MSandro93/solaranlage/Production Files/Rev_B/BOM_Solaranlage_Rev.B.xlsx

Quantity | Designator | Value | Supplier | Ordering | Description
1 | BZ1 | AL-60SP05/HT | Conrad | 541347-62 | Buzzer, polarized | o
2 | C12 C13 | 10p | Conrad | 1589402-62 | Unpolarized capacitor
7 | C1 C5 C6 C8 C9 C15 C20 | 10n | Conrad | 1235236-62 | Unpolarized capacitor | o
10 | C2 C3 C4 C10 C14 C17 C19 C21 C7 C22 | 100n | Conrad | 1235240-62 | Unpolarized capacitor | o
4 | C11 C16 C18 C23 | 10uF | Conrad | 1688108-62 | Polarized capacitor | o
5 | D8 D9 D10 D11 D14 | D_TVS | Conrad | 140810-62 | TVS diode | o
2 | D2 D3 | LED_green_5mm | Conrad | 1573746-62 | Light emitting diode | o
1 | D1 | LED_red_5mm | Conrad | 1573740-62 | Light emitting diode | o
6 | D4 D5 D6 D7 D12 D13 | LED_yellow_3mm | Conrad | 1573698-62 | Light emitting diode | o
1 | F1 | Fuse | Conrad | 1898867-62 / 1898865-62 | Fuse | o
1 | J3 | AVR-JTAG-10 | Conrad | 1088159-62 | Atmel 10-pin JTAG connector | o
3 | J1 J2 J6 | Screw_Terminal_01x02 | Digikey | A98092-ND | Screw terminal, single row, 01x02
1 | J7 | Screw_Terminal_01x03 | Digikey | A98093-ND | Screw terminal, single row, 01x03
2 | J4 J5 | USB_B | Conrad | 1883654-62 |  | o
1 | JP1 | Jumper | Conrad | 739443-62 / 734129-62 | Jumper, normally closed | o
3 | L1 L2 L3 | 10uH | Conrad | 440313-62 | Inductor symbol for simulation only | o
1 | MECH5 | Socket for ATMega32 (U7) | Reichelt | GS 40P
2 | MECH1 MECH2 | Socket for NE555 (U10) | Conrad | 189600-62 |  | o
2 | MECH3 MECH4 | Socket for buffer (U11) | Conrad | 189626-62 |  | o
2 | Q1 Q2 | 2N3904 | Reichelt | 2N 3904 | 0.2A Ic, 40V Vce, Small Signal NPN Transistor, TO-92
8 | R3 R4 R5 R6 R7 R8 R9 R10 | 220 | Reichelt | YAG FTE52-220R | Resistor
6 | R25 R26 R27 R28 R31 R32 | 330 | Reichelt | METALL 330 | Resistor
3 | R17 R18 R20 | 560 | Reichelt | YAG FTE52-560R | Resistor
8 | R1 R2 R12 R13 R19 R21 R23 R35 | 1k | Reichelt | VIS C1001FC100 | Resistor
1 | R33 | 4k7 | Reichelt | VIS C4701FC100 | Resistor
9 | R11 R14 R15 R16 R22 R24 R29 R30 R34 | 10k | Reichelt | METALL 10,0K | Resistor
2 | RV1 RV2 | R_POT_TRIM | Conrad | 447564-62 | Trim-potentiometer | o
1 | SW2 | 100SP1T1B4M2QE | Digikey | EG2355-ND | Switch, single pole double throw
1 | SW1 | Rotary_Encoder | Digikey | P12423-ND | Rotary_Encoder
1 | U12 | 74HC595 | Reichelt | 74HC 595 | 8-bit serial in/out Shift Register 3-State Outputs
1 | U11 | 74LS126 | Reichelt | LS 126 | Quad buffer 3-State outputs
1 | U7 | ATmega32-16PU | Reichelt | ATMEGA 32-16 DIP | MCU
1 | U8 | FT232RL | Reichelt | FT 232 RL | USB to Serial Interface, SSOP-28
1 | U9 | MCP6002-I/P | Conrad | 651489-62 | Dual Rail-to-rail CMOS Operational Amplifier, DIP-8/SOIC-8 | o
1 | U10 | NE555P | Reichelt | NE 555 TEX | Precision Timers, 555 compatible, PDIP-8
6 | U1 U2 U3 U4 U5 U6 | SC56-11E* | Reichelt | SC 56-11 RT | One digit 7 segment hyper red LED, common cathode
1 | Y1 | 7.3728 Mhz | Reichelt | 7,3728-HC49U-S | Two pin crystal
1 | - | Nuts M3 | Reichelt | SZK M3X6-200 | 200-pack of M3 screws for mechanical assembly
6 | - | distance bolt M3 | Reichelt | VT DA 12MM | distance bolts for mechanical assembly
1 | - | screw M3 | Reichelt | SK-E M3-100 | 100-pack of M3 nuts for mechanical assembly
