MSandro93/solaranlage/3D/fuse_asm.stp

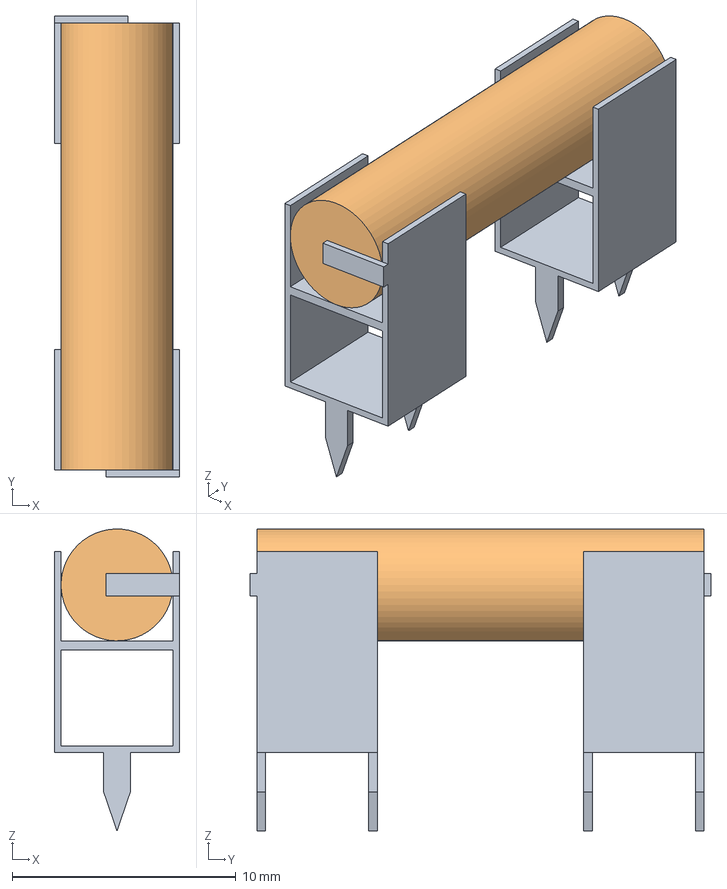
[picture p1: CAD file, 2021-03-04]
3D/fuse_asm.stp
5.60 x 20.6 x 13.5 mm
fuse_clip x 2
fuse
