MSandro93/solaranlage/3D/dispaly_cover.stp

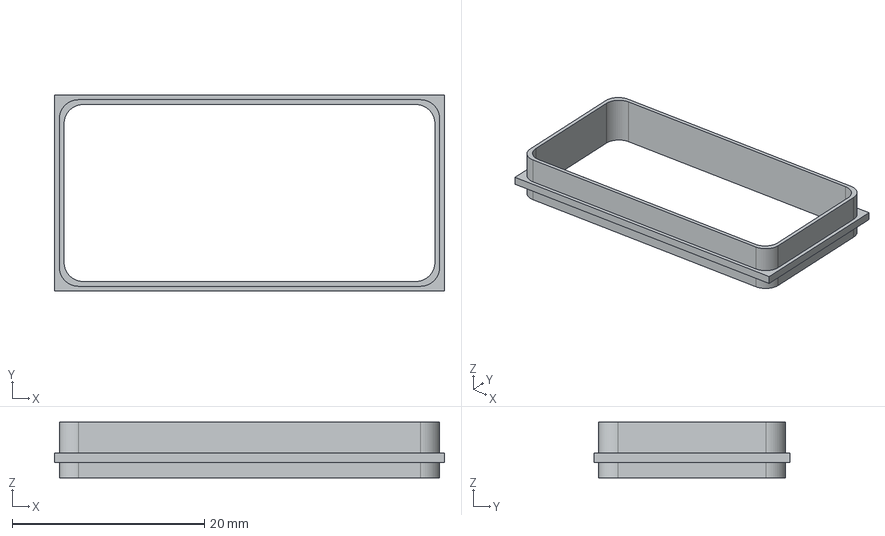
[picture p2: CAD file, 2021-03-14]
3D/dispaly_cover.stp
40.6 x 20.4 x 5.79 mm
