MSandro93/solaranlage/3D/frontplate.step

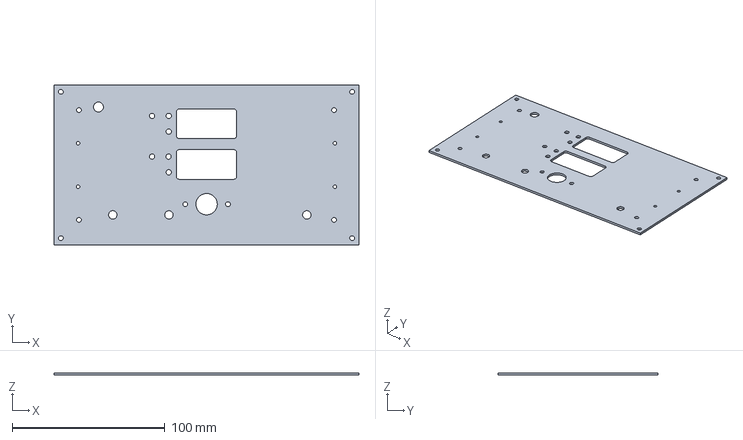
[picture p3: CAD file, 2021-03-12]
3D/frontplate.step
200.0 x 105.0 x 1.60 mm
