MSandro93/solaranlage/3D/terminal_block_x3.STEP.STEP

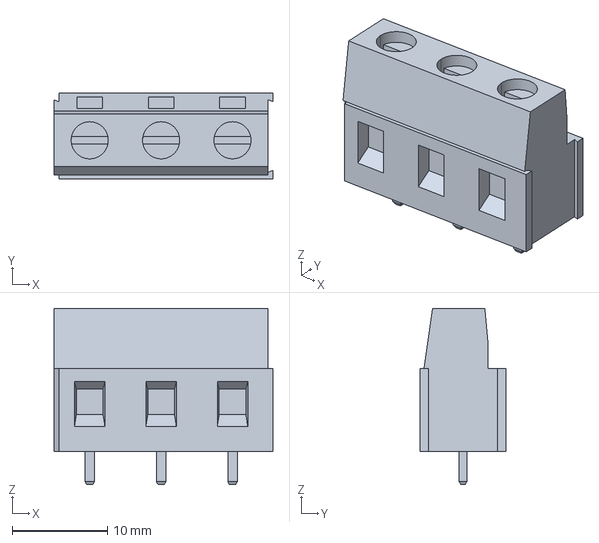
[picture p4: CAD file, 2021-03-02]
3D/terminal_block_x3.STEP.STEP
23.0 x 9.00 x 18.5 mm
