MSandro93/solaranlage/3D/terminal_block_x2.STEP

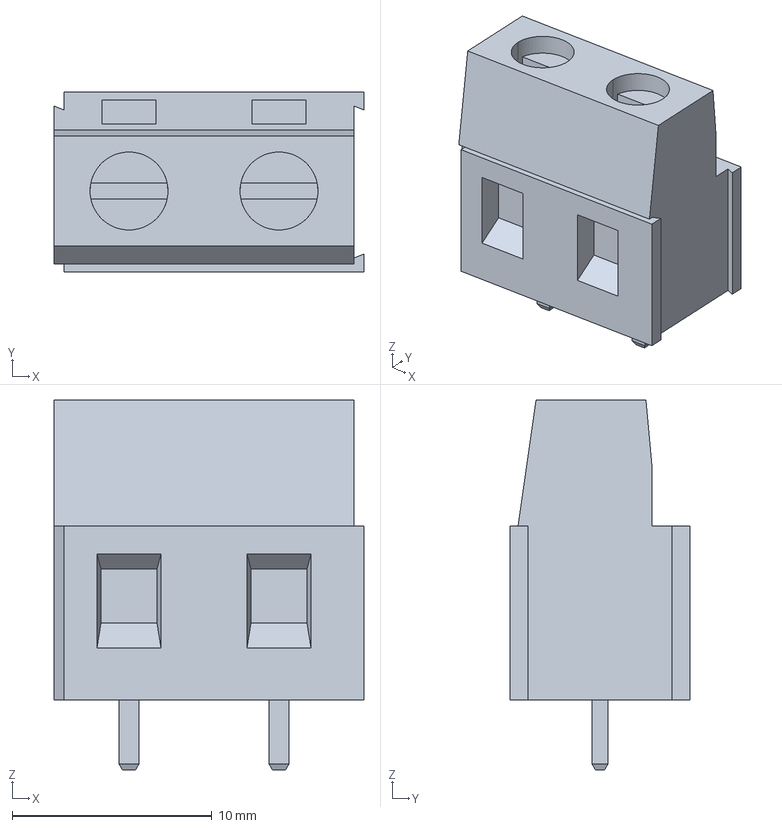
[picture p5: CAD file, 2021-03-02]
3D/terminal_block_x2.STEP
15.5 x 9.00 x 18.5 mm
