MSandro93/solaranlage/3D/encoder.stp

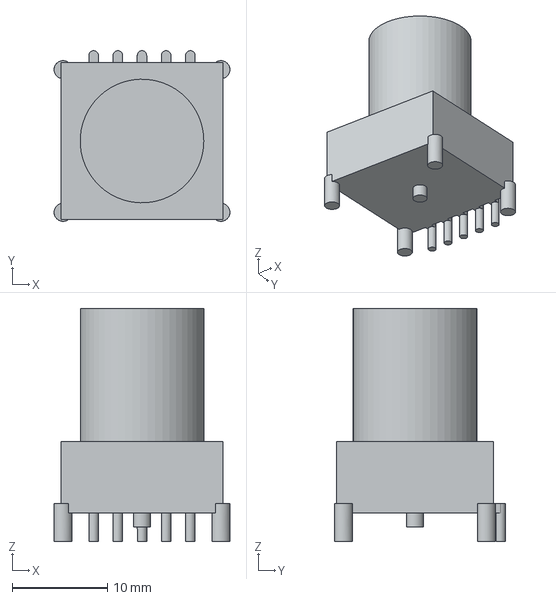
[picture p6: CAD file, 2021-02-25]
3D/encoder.stp
18.5 x 17.9 x 24.5 mm
