MSandro93/solaranlage/3D/toggle_switch.STEP

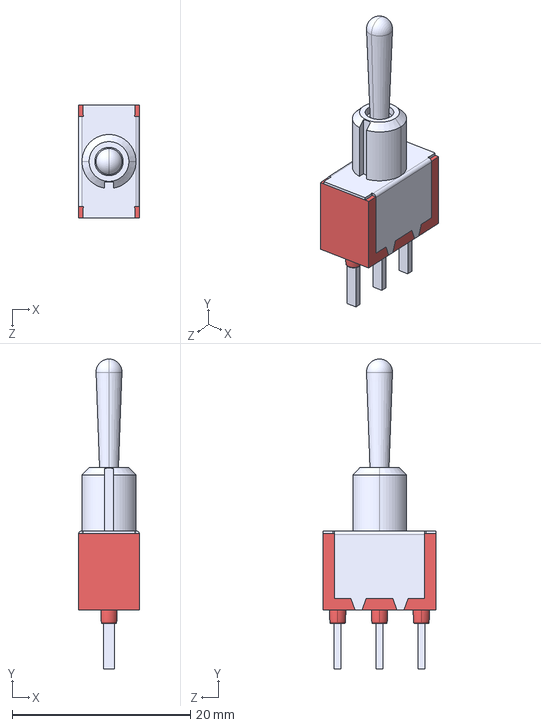
[picture p7: CAD file, 2021-02-25]
3D/toggle_switch.STEP
6.86 x 34.8 x 12.7 mm
