MSandro93/solaranlage/3D/USB_B.stp

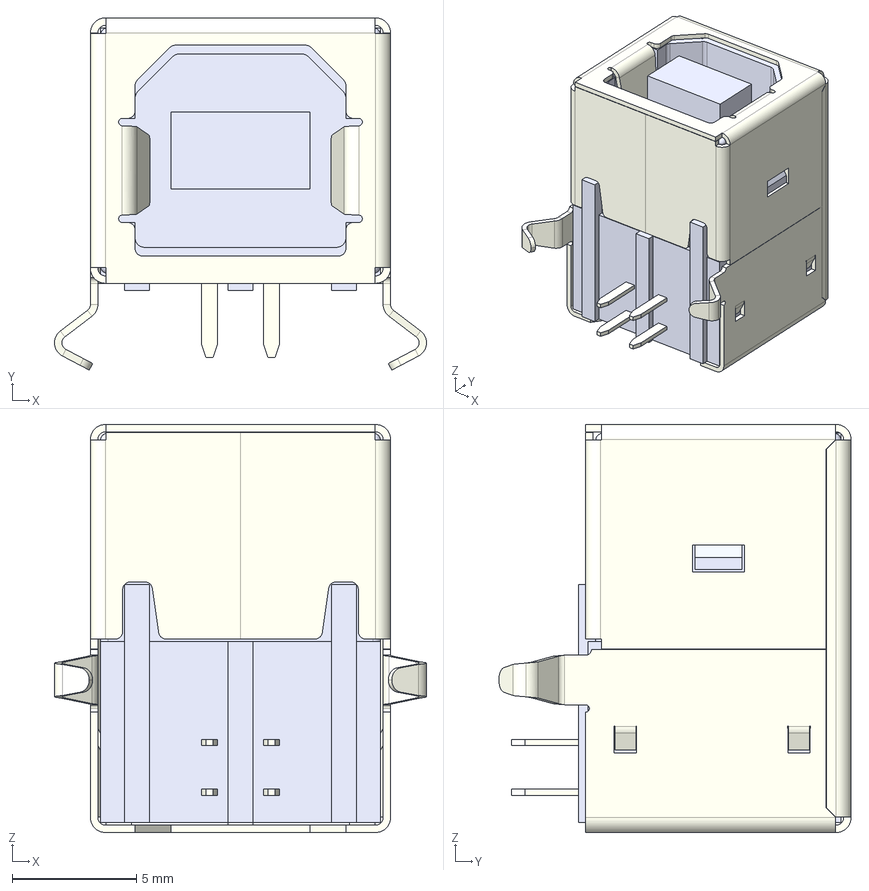
[picture p8: CAD file, 2021-02-25]
3D/USB_B.stp
15.0 x 14.2 x 16.5 mm
