MSandro93/solaranlage/3D/61201021721 (rev1).stp

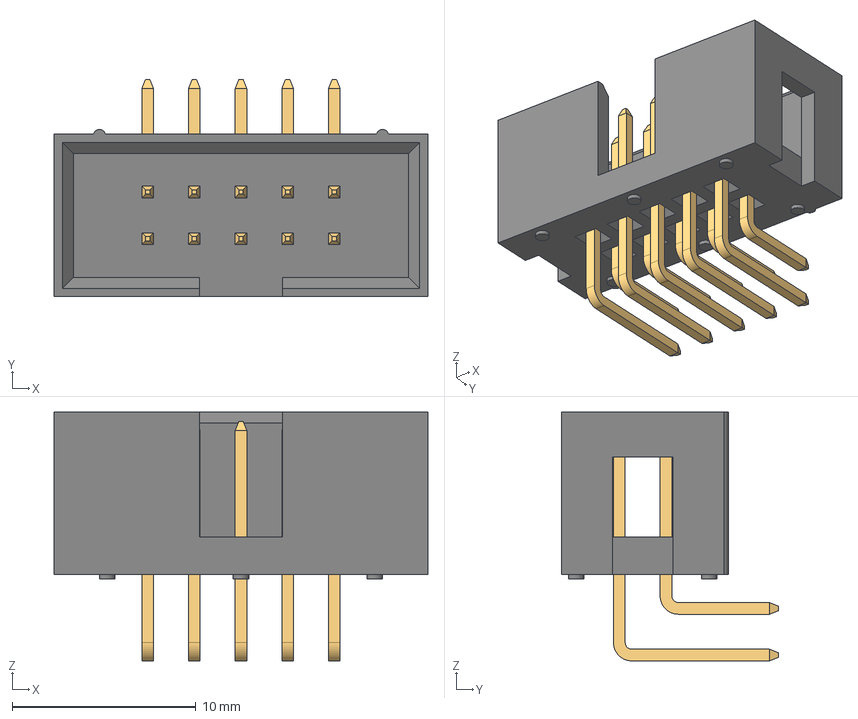
[picture p9: CAD file, 2021-03-04]
3D/61201021721 (rev1).stp
20.4 x 11.8 x 13.6 mm
6120xx21721_PIN x 5
6120xx21721_PIN_LONGUE x 5
