MSandro93/solaranlage/3D/696101000002 (rev1).stp

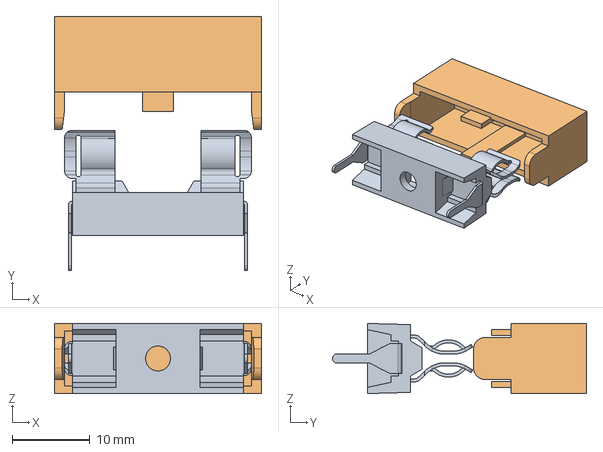
[picture p10: CAD file, 2021-03-04]
3D/696101000002 (rev1).stp
26.6 x 32.6 x 9.00 mm
