MSandro93/solaranlage/Production Files/Rev_B/SCH_Solaranlage_Rev.B.pdf

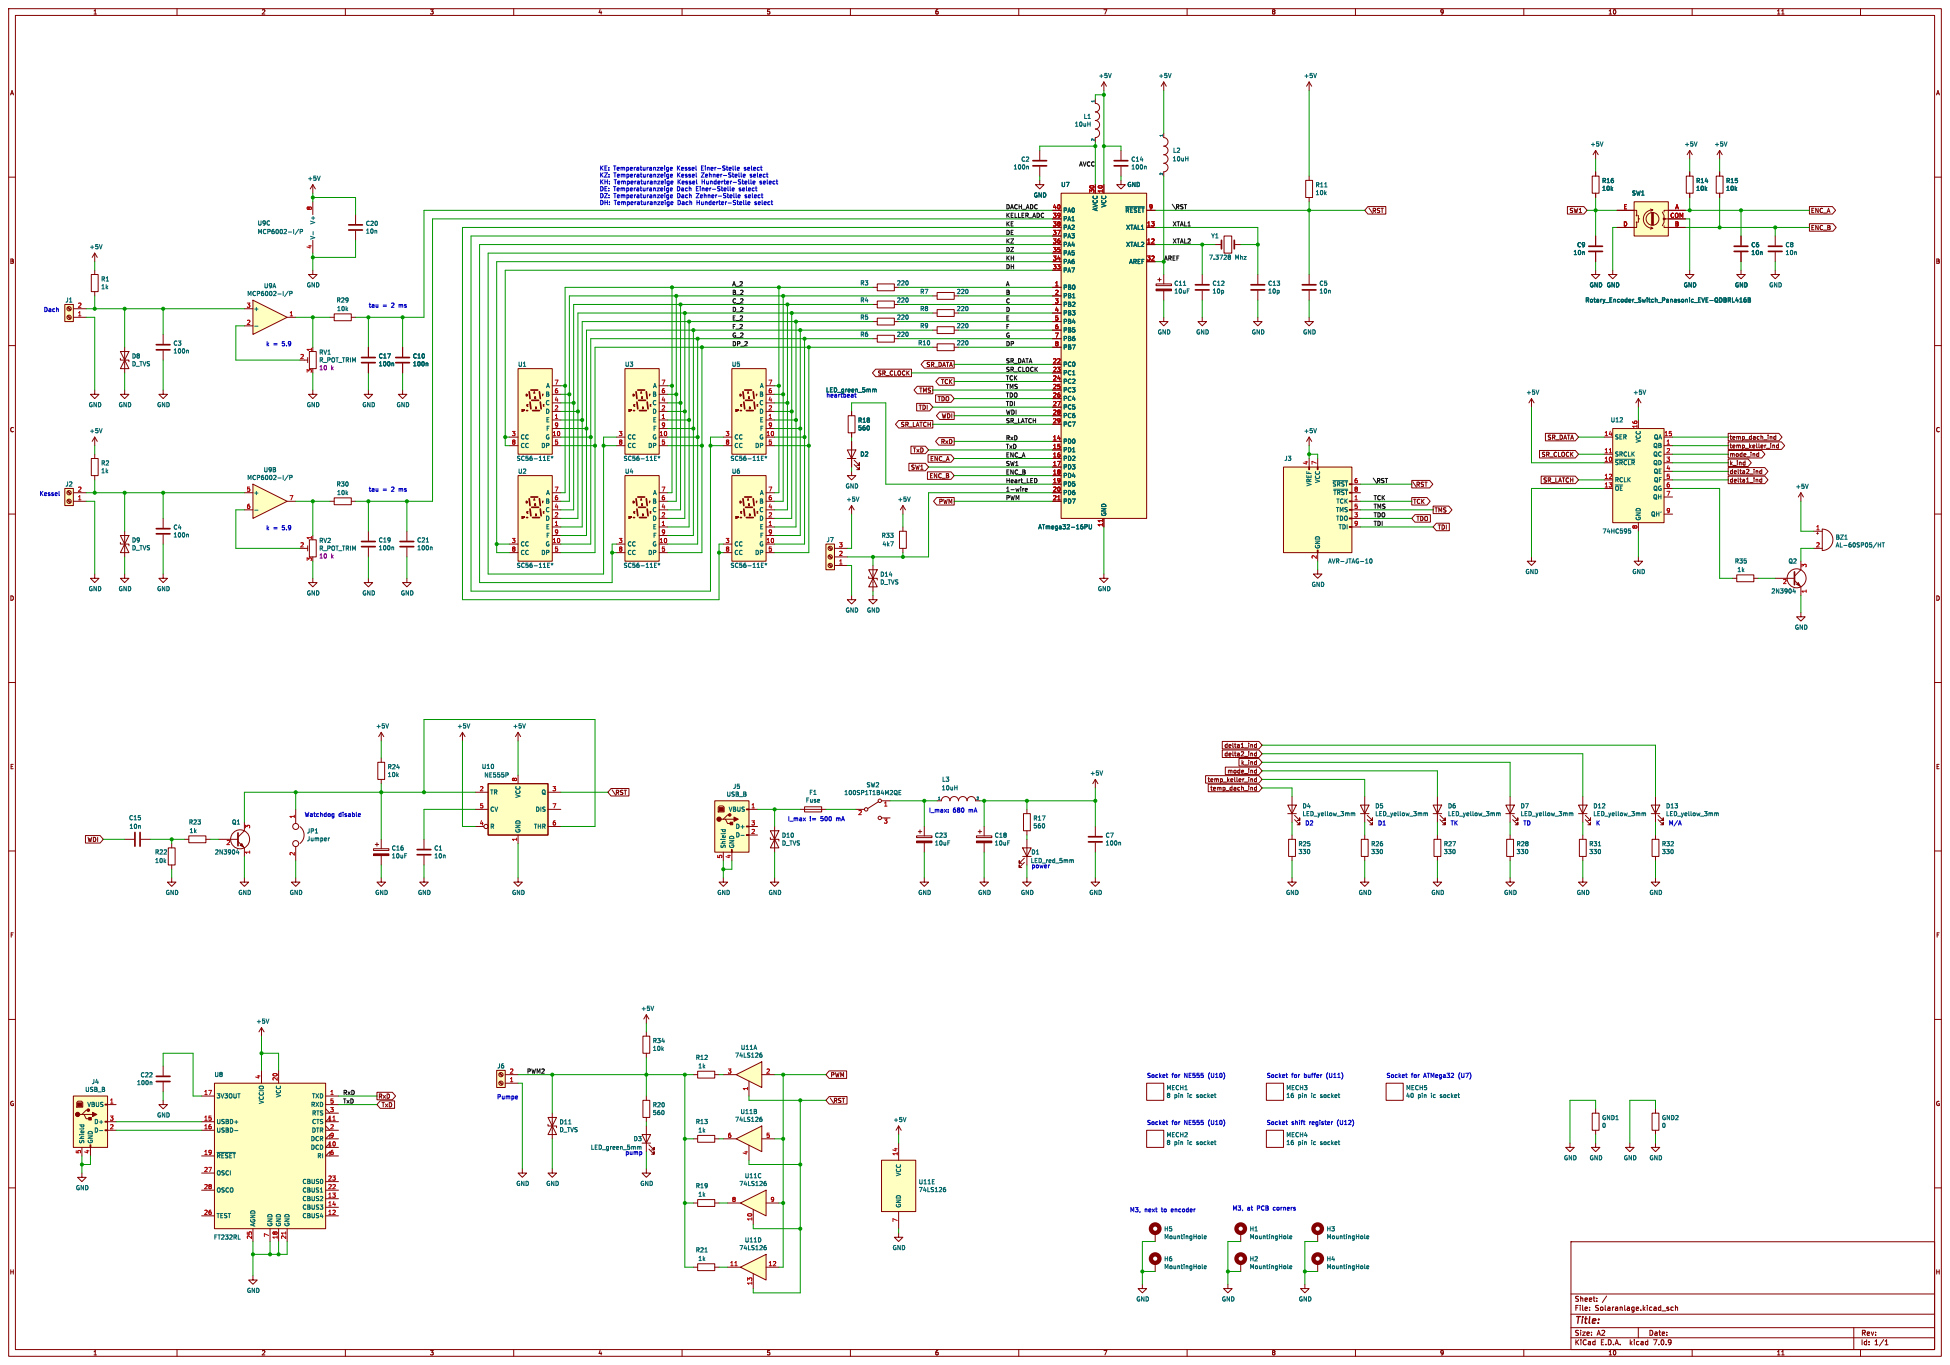
[picture p11: page 1]

8 U9C MCP6002-I/P GND GND GND GND GND

TXD 1 DCD 10 CTS 11 CBUS4 12 CBUS2 13 CBUS3 14 USBD+ 15 USBD- 16

40 pin ic socket GND

16 pin ic socket H3 MountingHole
