MSandro93/solaranlage/Solaranlage.kicad_pcb

## KiCad design Solaranlage.kicad_pcb (2024-04-17)

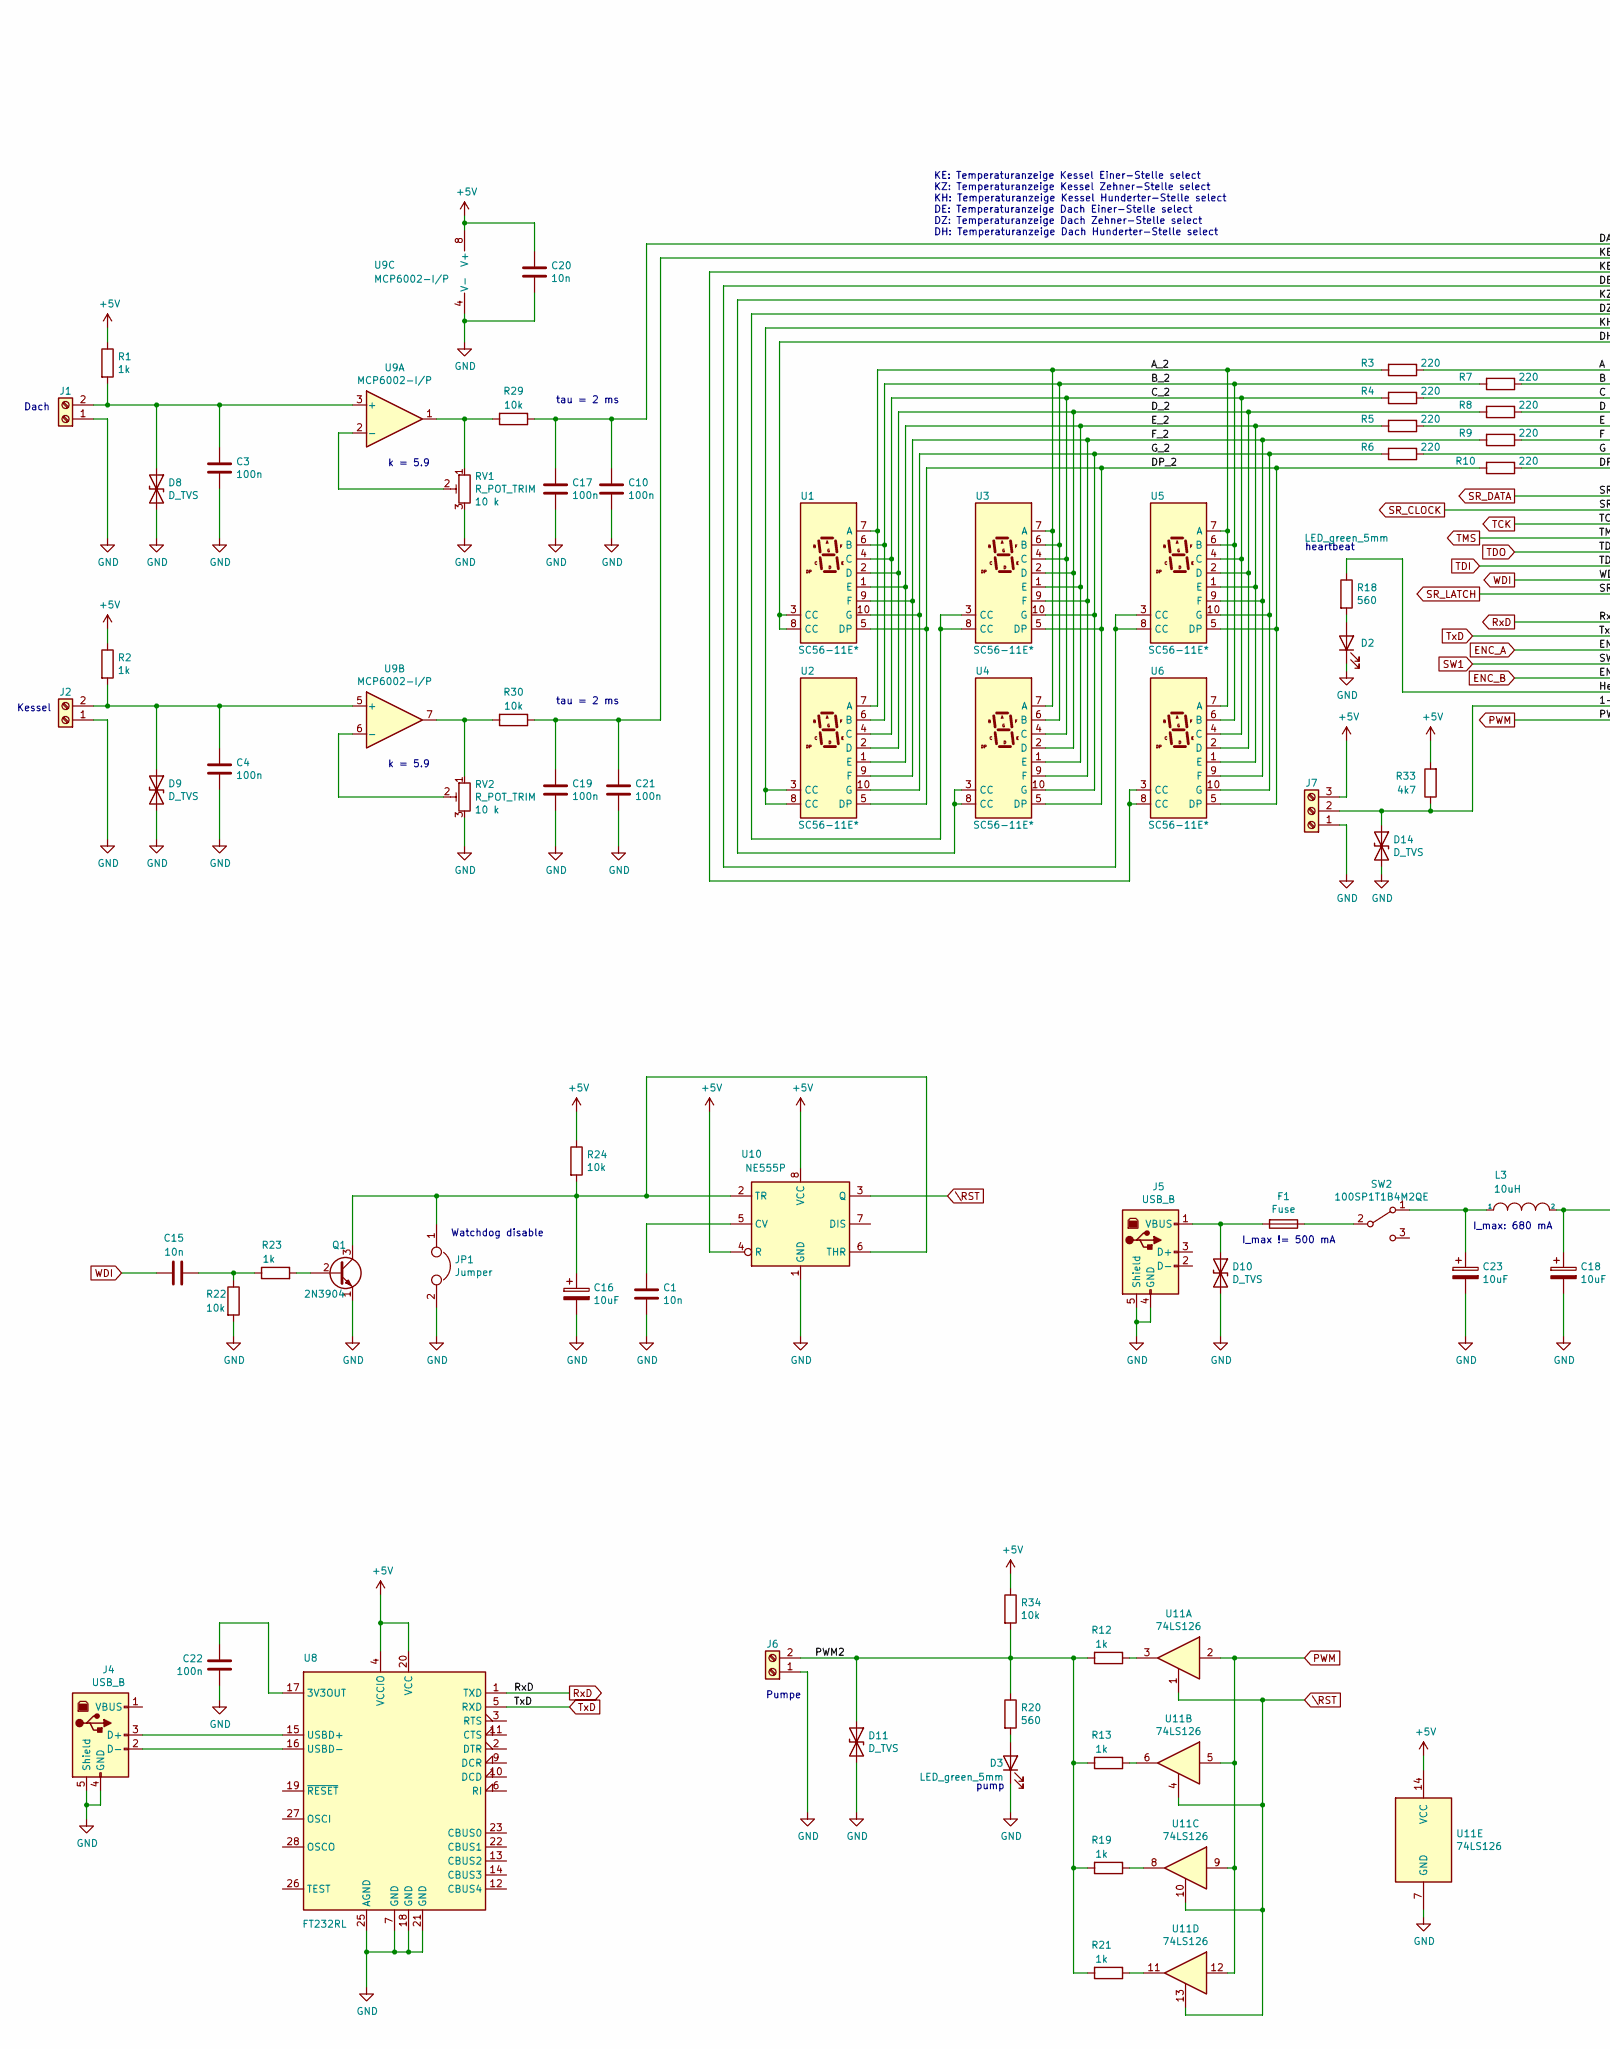
[picture p12: schematic Solaranlage.kicad_sch, part in row 1, column 1]

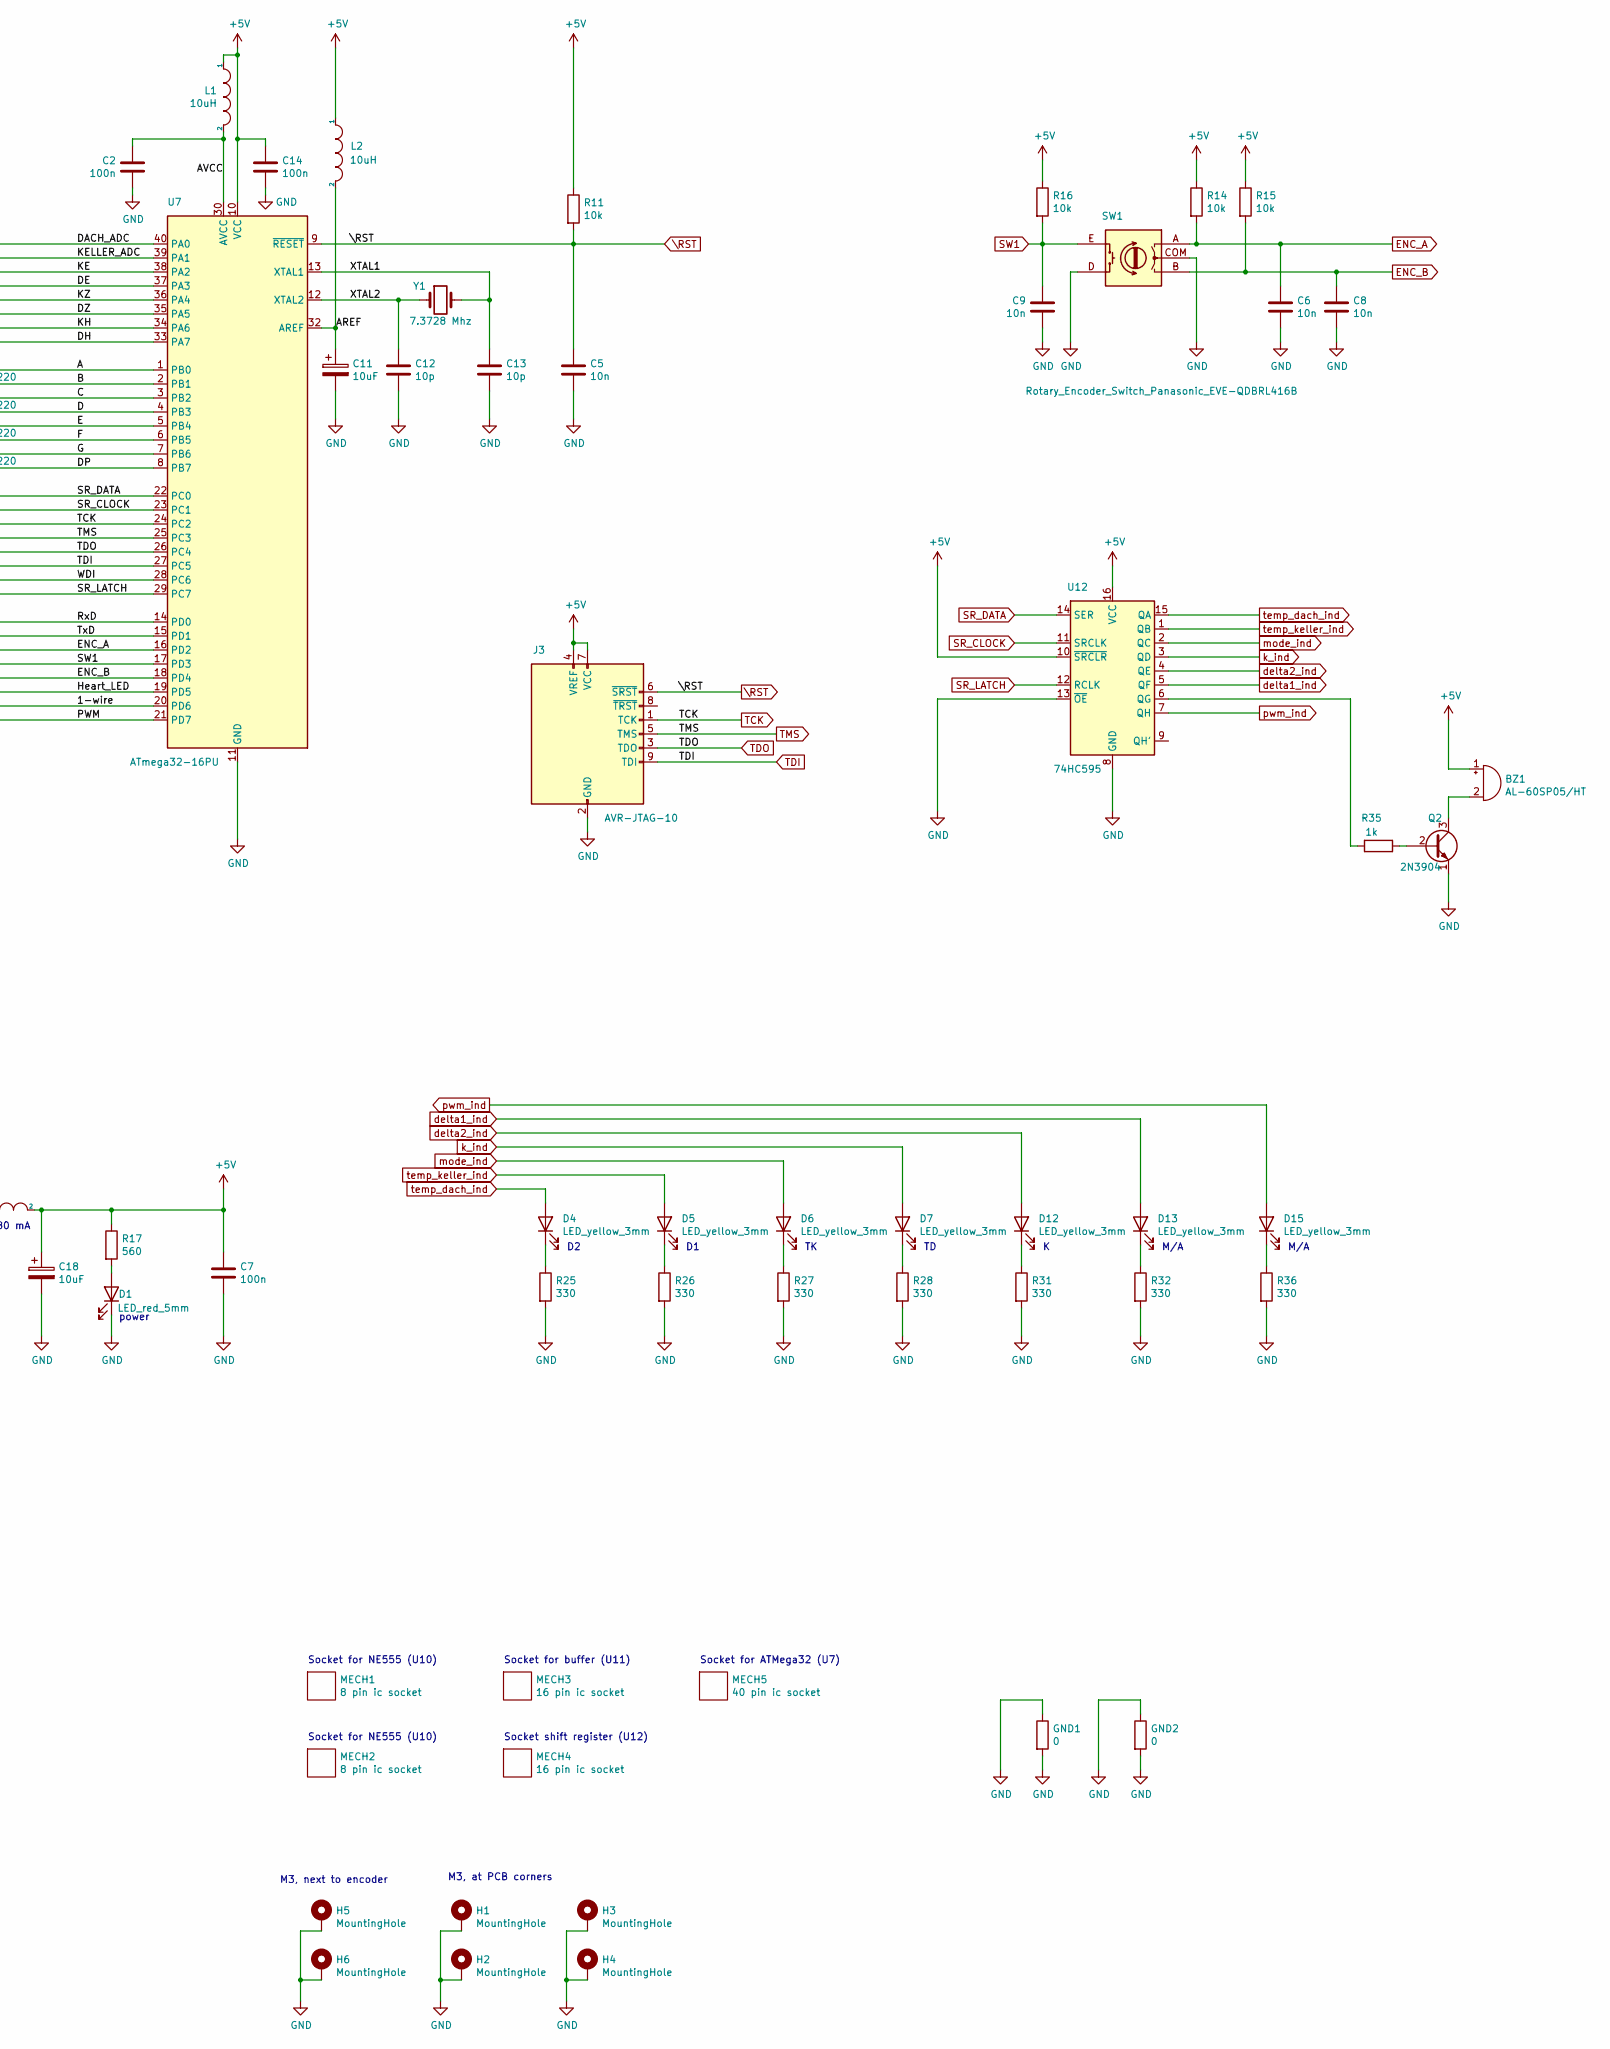
[picture p13: schematic Solaranlage.kicad_sch, part in row 1, column 2]

Parts:
BZ1: AL-60SP05/HT; Buzzer_12x9.5RM7.6
C1, C5, C6, C8, C9, C15, C20: 10n; C_Rect_L7.2mm_W2.5mm_P5.00mm_FKS2_FKP2_MKS2_MKP2
C2, C3, C4, C7, C10, C14, C17, C19, C21, C22: 100n; C_Rect_L7.2mm_W2.5mm_P5.00mm_FKS2_FKP2_MKS2_MKP2
C11, C16, C18, C23: 10uF; CP_Radial_D6.3mm_P2.50mm
C12, C13: 10p; C_Disc_D4.7mm_W2.5mm_P5.00mm
D1: LED_red_5mm; LED_D5.0mm
D2, D3: LED_green_5mm; LED_D5.0mm
D4, D5, D6, D7, D12, D13, D15: LED_yellow_3mm; LED_D3.0mm
D8, D9, D10, D11, D14: D_TVS; D_DO-201_P3.81mm_Vertical_KathodeUp
F1: Fuse; 696101000002
GND1, GND2: 0; R_Axial_DIN0204_L3.6mm_D1.6mm_P7.62mm_Horizontal
H1, H2, H3, H4: MountingHole; MountingHole_3.2mm_M3_Pad_Via
H5, H6: MountingHole; MountingHole_3.2mm_M3_DIN965_Pad
J1, J2, J6: Screw_Terminal_01x02; TerminalBlock_MetzConnect_Type171_RT13702HBWC_1x02_P7.50mm_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
J3: AVR-JTAG-10; PinSocket_2x05_P2.54mm_Horizontal
J4, J5: USB_B; USB_B_Lumberg_2411_02_Horizontal
J7: Screw_Terminal_01x02; TerminalBlock_MetzConnect_Type171_RT13703HBWC_1x03_P7.50mm_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
JP1: Jumper; PinHeader_1x03_P2.54mm_Vertical
L1, L2, L3: 10uH; L_Axial_L9.5mm_D4.0mm_P5.08mm_Vertical_Fastron_SMCC
MECH1, MECH2: 8 pin ic socket; void
MECH3, MECH4: 16 pin ic socket; void
MECH5: 40 pin ic socket; void
Q1, Q2: 2N3904; TO-92L_Wide
R1, R2, R12, R13, R19, R21, R23, R35: 1k; R_Axial_DIN0204_L3.6mm_D1.6mm_P7.62mm_Horizontal
R3, R4, R5, R6, R7, R8, R9, R10: 220; R_Axial_DIN0204_L3.6mm_D1.6mm_P7.62mm_Horizontal
R11, R14, R15, R16, R22, R24, R29, R30, R34: 10k; R_Axial_DIN0204_L3.6mm_D1.6mm_P7.62mm_Horizontal
R17, R18, R20: 560; R_Axial_DIN0204_L3.6mm_D1.6mm_P7.62mm_Horizontal
R25, R26, R27, R28, R31, R32, R36: 330; R_Axial_DIN0204_L3.6mm_D1.6mm_P7.62mm_Horizontal
R33: 4k7; R_Axial_DIN0204_L3.6mm_D1.6mm_P7.62mm_Horizontal
RV1, RV2: R_POT_TRIM; Potentiometer_Bourns_3299W_Vertical
SW1: Rotary_Encoder_Switch_Panasonic_EVE-QDBRL416B; Encoder_Panasonic_EVE-QDBRL416B
SW2: 100SP1T1B4M2QE; sw_pole_3-pol.
U1, U2, U3, U4, U5, U6: SC56-11E*; 7SegmentLED_LTS6760_LTS6780
U7: ATmega32-16PU; DIP-40_W15.24mm
U8: FT232RL; SSOP-28_5.3x10.2mm_P0.65mm
U9: MCP6002-I/P; DIP-8_W7.62mm_LongPads
U10: NE555P; DIP-8_W7.62mm
U11: 74LS126; DIP-14_W7.62mm
U12: 74HC595; DIP-16_W7.62mm
Y1: 7.3728 Mhz; Crystal_HC18-U_Vertical

Connections:
+5V: BZ1.1 (-), C7.1, C14.1, C18.1, C20.1, J3.4 (VREF), J3.7 (VCC), J7.3, L1.1, L2.1, L3.2, R1.1, R2.1, R11.1, R14.1, R15.1, R16.1, R17.1, R24.1, R33.2, R34.1, U7.10 (VCC), U8.4 (VCCIO), U8.20 (VCC), U9.8 (V+), U10.4 (R), U10.8 (VCC), U11.14 (VCC), U12.10 (~SRCLR), U12.16 (VCC)
/1-wire: D14.1 (A1), J7.2, R33.1, U7.20 (PD6)
/A: R3.1, U7.1 (PB0)
/AREF: C11.1, L2.2, U7.32 (AREF)
/AVCC: C2.1, L1.2, U7.30 (AVCC)
/A_2: R3.2, U1.7 (A), U2.7 (A), U3.7 (A), U4.7 (A), U5.7 (A), U6.7 (A)
/B: R7.1, U7.2 (PB1)
/B_2: R7.2, U1.6 (B), U2.6 (B), U3.6 (B), U4.6 (B), U5.6 (B), U6.6 (B)
/C: R4.1, U7.3 (PB2)
/C_2: R4.2, U1.4 (C), U2.4 (C), U3.4 (C), U4.4 (C), U5.4 (C), U6.4 (C)
/D: R8.1, U7.4 (PB3)
/DACH_ADC: C10.1, C17.1, R29.1, U7.40 (PA0)
/DE: U5.3 (CC), U5.8 (CC), U7.37 (PA3)
/DH: U1.3 (CC), U1.8 (CC), U7.33 (PA7)
/DP: R10.1, U7.8 (PB7)
/DP_2: R10.2, U1.5 (DP), U2.5 (DP), U3.5 (DP), U4.5 (DP), U5.5 (DP), U6.5 (DP)
/DZ: U3.3 (CC), U3.8 (CC), U7.35 (PA5)
/D_2: R8.2, U1.2 (D), U2.2 (D), U3.2 (D), U4.2 (D), U5.2 (D), U6.2 (D)
/E: R5.1, U7.5 (PB4)
/E_2: R5.2, U1.1 (E), U2.1 (E), U3.1 (E), U4.1 (E), U5.1 (E), U6.1 (E)
/F: R9.1, U7.6 (PB5)
/F_2: R9.2, U1.9 (F), U2.9 (F), U3.9 (F), U4.9 (F), U5.9 (F), U6.9 (F)
/G: R6.1, U7.7 (PB6)
/G_2: R6.2, U1.10 (G), U2.10 (G), U3.10 (G), U4.10 (G), U5.10 (G), U6.10 (G)
/Heart_LED: R18.1, U7.19 (PD5)
/KE: U6.3 (CC), U6.8 (CC), U7.38 (PA2)
/KELLER_ADC: C19.1, C21.1, R30.1, U7.39 (PA1)
/KH: U2.3 (CC), U2.8 (CC), U7.34 (PA6)
/KZ: U4.3 (CC), U4.8 (CC), U7.36 (PA4)
/PWM2: D11.1 (A1), J6.2, R12.2, R13.2, R19.2, R20.1, R21.2, R34.2
/XTAL1: C13.1, U7.13 (XTAL1), Y1.2
/XTAL2: C12.1, U7.12 (XTAL2), Y1.1
ENC_A: C6.1, R14.2, SW1.A, U7.16 (PD2)
ENC_B: C8.1, R15.2, SW1.B, U7.18 (PD4)
GND: C1.2, C2.2, C3.2, C4.2, C5.2, C6.2, C7.2, C8.2, C9.2, C10.2, C11.2, C12.2, C13.2, C14.2, C16.2, C17.2, C18.2, C19.2, C20.2, C21.2, C22.2, C23.2, D1.1 (K), D2.1 (K), D3.1 (K), D8.2 (A2), D9.2 (A2), D10.2 (A2), D11.2 (A2), D14.2 (A2), GND1.1, GND1.2, GND2.1, GND2.2, H1.1, H2.1, H3.1, H4.1, H5.1, H6.1, J1.1, J2.1, J3.2 (GND), J3.10 (GND), J4.4 (GND), J4.5 (Shield), J5.4 (GND), J5.5 (Shield), J6.1, J7.1, JP1.2, Q1.1 (E), Q2.1 (E), R22.2, R25.2, R26.2, R27.2, R28.2, R31.2, R32.2, R36.2, RV1.3, RV2.3, SW1.COM, SW1.D, U7.11 (GND), U7.31 (GND), U8.7 (GND), U8.18 (GND), U8.21 (GND), U8.25 (AGND), U9.4 (V-), U10.1 (GND), U11.7 (GND), U12.8 (GND), U12.13 (~OE)
unnamed: BZ1.2 (+), Q2.3 (C)
unnamed: C15.2, R22.1, R23.1
unnamed: D1.2 (A), R17.2
unnamed: D2.2 (A), R18.2
unnamed: D3.2 (A), R20.2
unnamed: D4.1 (K), R25.1
unnamed: D5.1 (K), R26.1
unnamed: D6.1 (K), R27.1
unnamed: D7.1 (K), R28.1
unnamed: C3.1, D8.1 (A1), J1.2, R1.2, U9.3 (+)
unnamed: C4.1, D9.1 (A1), J2.2, R2.2, U9.5 (+)
unnamed: D10.1 (A1), F1.2, J5.1 (VBUS)
unnamed: D12.1 (K), R31.1
unnamed: D13.1 (K), R32.1
unnamed: D15.1 (K), R36.1
unnamed: J4.3 (D+), U8.15 (USBD+)
unnamed: J4.2 (D-), U8.16 (USBD-)
unnamed: Q1.2 (B), R23.2
unnamed: C16.1, JP1.1, Q1.3 (C), R24.2, U10.2 (TR), U10.6 (THR)
unnamed: Q2.2 (B), R35.1
unnamed: R12.1, U11.3
unnamed: R13.1, U11.6
unnamed: R19.1, U11.8
unnamed: R21.1, U11.11
unnamed: R29.2, RV1.1, U9.1
unnamed: R30.2, RV2.1, U9.7
unnamed: C23.1, L3.1, SW2.1 (A)
unnamed: F1.1, SW2.2 (B)
unnamed: C22.1, U8.17 (3V3OUT)
unnamed: RV1.2, U9.2 (-)
unnamed: RV2.2, U9.6 (-)
unnamed: C1.1, U10.5 (CV)
unnamed: R35.2, U12.6 (QG)
PWM: U7.21 (PD7), U11.2, U11.5, U11.9, U11.12
RxD: U7.14 (PD0), U8.1 (TXD)
SR_CLOCK: U7.23 (PC1), U12.11 (SRCLK)
SR_DATA: U7.22 (PC0), U12.14 (SER)
SR_LATCH: U7.29 (PC7), U12.12 (RCLK)
SW1: C9.1, R16.2, SW1.E, U7.17 (PD3)
TCK: J3.1 (TCK), U7.24 (PC2)
TDI: J3.9 (TDI), U7.27 (PC5)
TDO: J3.3 (TDO), U7.26 (PC4)
TMS: J3.5 (TMS), U7.25 (PC3)
TxD: U7.15 (PD1), U8.5 (RXD)
WDI: C15.1, U7.28 (PC6)
\RST: C5.1, J3.6 (~SRST), R11.2, U7.9 (~RESET), U10.3 (Q), U11.1, U11.4, U11.10, U11.13
delta1_ind: D13.2 (A), U12.5 (QF)
delta2_ind: D12.2 (A), U12.4 (QE)
k_ind: D7.2 (A), U12.3 (QD)
mode_ind: D6.2 (A), U12.2 (QC)
pwm_ind: D15.2 (A), U12.7 (QH)
temp_dach_ind: D4.2 (A), U12.15 (QA)
temp_keller_ind: D5.2 (A), U12.1 (QB)

Notes on the sheet:
Socket for NE555 (U10)
I_max: 680 mA
Pumpe
k = 5.9
pump
M/A
Kessel
Dach
Watchdog disable
Socket for ATMega32 (U7)
heartbeat
power
tau = 2 ms
I_max != 500 mA
Socket shift register (U12)
M3, next to encoder
M3, at PCB corners
KE: Temperaturanzeige Kessel Einer-Stelle select KZ: Temperaturanzeige Kessel Zehner-Stelle select KH: Temperaturanzeige Kessel Hunderter-Stelle select DE: Temperaturanzeige Dach Einer-Stelle select DZ: Temperaturanzeige Dach Zehner-Stelle select DH: Temperaturanzeige Dach Hunderter-Stelle select
Socket for buffer (U11)

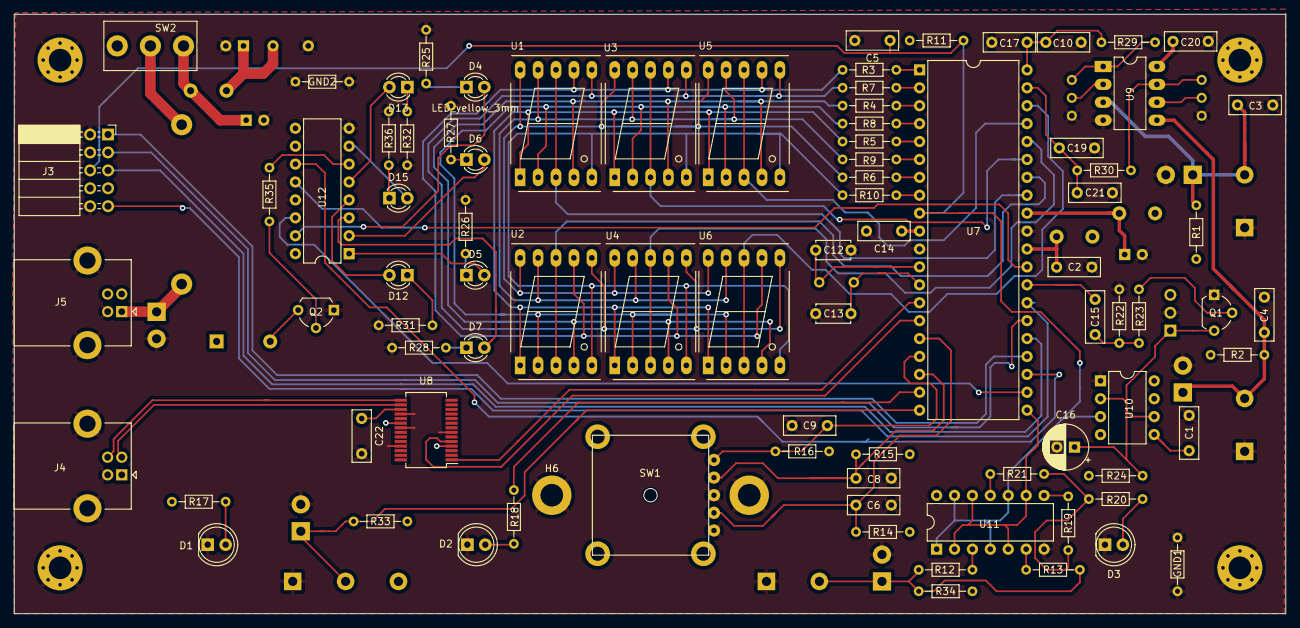
[picture p14: board Solaranlage.kicad_pcb from above]

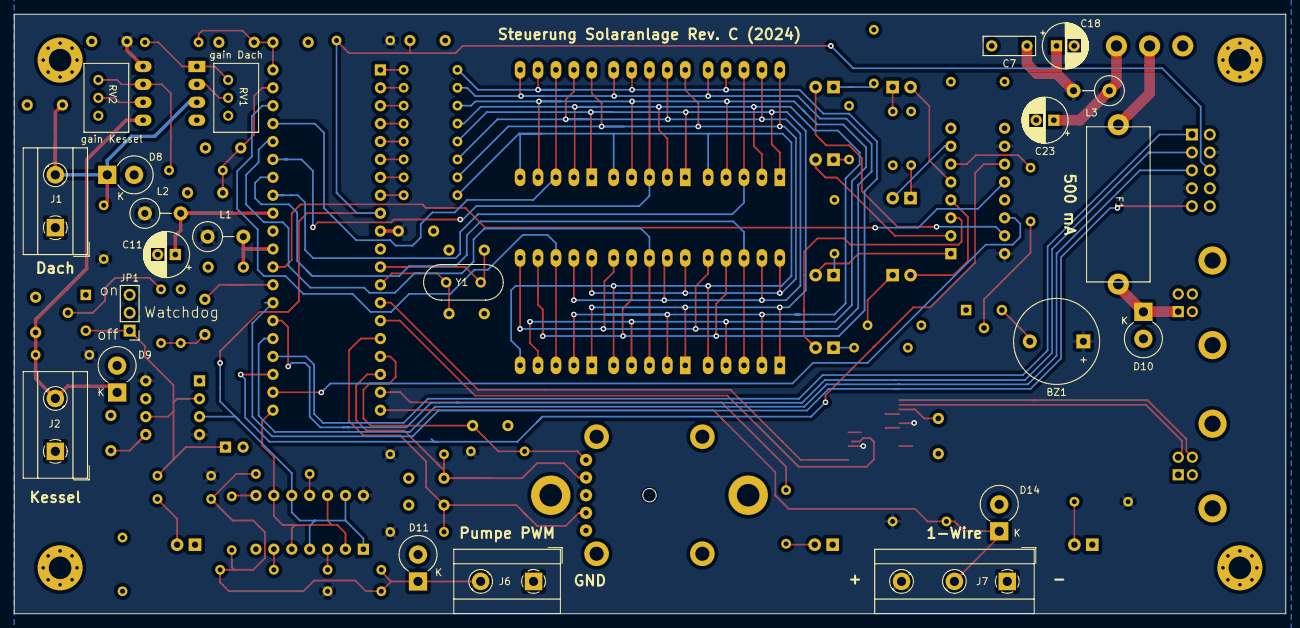
[picture p15: board Solaranlage.kicad_pcb from below]

Board: 2 copper layers, 180.3 x 85.0 mm, 119 parts (22 on the bottom side), 88 nets.
