MSandro93/solaranlage/(commit log)

2020-10-28 production Rev.A
    [Solaranlage-B_Cu.gbr, Solaranlage-B_Mask.gbr, Solaranlage-B_Paste.gbr, Solaranlage-B_SilkS.gbr, Solaranlage-Edge_Cuts.gbr, Solaranlage-F_Cu.gbr, Solaranlage-F_Mask.gbr, Solaranlage-F_Paste.gbr]
2020-10-28 fixed designator and value of input-C (C18)
    [Solaranlage.kicad_pcb, Solaranlage.sch]
2020-10-29 attached AREF-pin to 5V
    [Solaranlage.sch]
2020-10-29 ... and applied to layout
    [Solaranlage.kicad_pcb]
2020-10-29 flipped designator C3 and R1 in silk screen
    [Solaranlage.kicad_pcb, Solaranlage.sch]
2020-11-08 fixed reset of ne555
    [Solaranlage.sch]
2020-11-09 changed MCU from atmega32 to atmega644 because of availability;added 12p->GND to TCK to make JTAG working
    [Solaranlage.kicad_pcb, Solaranlage.sch]
2020-11-09 added Q2 to watchdog circuit;
    [Solaranlage.kicad_pcb, Solaranlage.sch]
2020-11-09 changed MCU back to atmega32
    [Solaranlage.kicad_pcb, Solaranlage.sch]
2020-11-11 added simualtion for analog amp; applied changes in footprints
    [Solaranlage.kicad_pcb, Solaranlage.sch]
2021-01-23 added amps for measureing
    [Solaranlage.kicad_pcb, Solaranlage.sch, Termofuehler.ods]
2021-01-23 applied changes to layout; added keepouts to supply of MCU and OP; DRC no issues
    [Solaranlage.kicad_pcb]
2021-01-24 resized schematic sheet
    [Solaranlage.kicad_pcb, Solaranlage.sch]
2021-01-25 added half done frontplate
    [Solaranlage.kicad_pcb]
2021-01-30 removed Q2. Had no plan why it was added. Inserted jumper to disable watchdog during sw-development
    [Solaranlage.kicad_pcb, Solaranlage.sch]
2021-02-22 fixed frequency of crystal in schematic
    [Solaranlage.kicad_pcb, Solaranlage.sch]
2021-02-22 removed C10 (for common mode blocking of pwm in case of stalling output), because the pwm frequency had to be lowered to 30 Hz
    [Solaranlage.kicad_pcb, Solaranlage.sch]
2021-02-23 added 1k serial resistance in the PWM output line to protect GPIO PD7 from burning down
    [Solaranlage.kicad_pcb, Solaranlage.sch]
2021-02-25 added LEDs to indicate what the displays show at the moment; added some 3D models; added 10k serial resistors to opamp-outs for TP
    [Solaranlage.kicad_pcb, Solaranlage.sch, USB_B.stp, encoder.stp, toggle_switch.STEP]
2021-02-25 added resistors to layout
    [Solaranlage.kicad_pcb]
2021-02-25 optimization layout
    [Solaranlage.kicad_pcb]
2021-02-27 adapted remarks from schematic review; added output buffer to PWM output
    [Solaranlage.kicad_pcb, Solaranlage.sch]
2021-02-28 added some datasheets and ordering numbers
    [Solaranlage.kicad_pcb, Solaranlage.sch]
2021-03-01 added shift register for GPIO expansion; edited board shape in order to make the display central; designed frontplate; added MCAD assembly to folder 3D;
    [Solaranlage.kicad_pcb, Solaranlage.sch, Solaranlage_assembly.cfg, frontplate.kicad_pcb, frontplate.step]
2021-03-01 added mcad assembly
    [Solaranlage_assembly.cfg, frontplate.kicad_pcb, frontplate.step]
2021-03-01 some cleaning
    [Solaranlage-B_Cu.gbr, Solaranlage-B_Mask.gbr, Solaranlage-B_Paste.gbr, Solaranlage-B_SilkS.gbr, Solaranlage-Edge_Cuts.gbr, Solaranlage-F_Cu.gbr, Solaranlage-F_Mask.gbr, Solaranlage-F_Paste.gbr]
2021-03-02 rounded up corners of cutout for display in the frontplate
    [Solaranlage.sch, frontplate.kicad_pcb]
2021-03-02 added optional 1-wire 'interface' (J7); added 3D models to terminal blocks
    [Solaranlage.kicad_pcb, Solaranlage.sch, terminal_block_x2.STEP, terminal_block_x3.STEP.STEP]
2021-03-02 added input protection and filtering to 1-wire input
    [Solaranlage.kicad_pcb, Solaranlage.sch]
2021-03-04 created BOM; added ordering codes; changes some footprints; etc.
    [61201021721 (rev1).stp, 696101000002 (rev1).stp, Solaranlage.kicad_pcb, Solaranlage.sch, Solaranlage_Rev.B.xlsx, Solaranlage_assembly.cfg, fuse_asm.cfg, fuse_asm.stp]
2021-03-04 replaced TVS diodes by diodes with higher breakdown voltage to minimize leakage current
    [Solaranlage.sch, Solaranlage_Rev.B.xlsx]
2021-03-12 Production state Rev.B
    [BOM_Solaranlage_Rev.B.xlsx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]
2021-03-12 fixes after receiving RevB PCBs: - increased diameter of H6 to 3.2mm; -decrease radius of hole for encoder to 6.5mm
    [Solaranlage.kicad_pcb, frontplate.kicad_pcb]
2021-03-12 added components for mechanical assembly to BOM
    [BOM_Solaranlage_Rev.B.xlsx]
2021-03-14 switched pinning of the shift-registers output pins
    [Solaranlage.kicad_pcb, Solaranlage.sch, dispaly_cover.stp, frontplate.kicad_pcb]
2021-03-14 increased diameter of the dills for the screws of te finger-grips to 3.2mm
    [frontplate.kicad_pcb]
2024-04-16 added PDF of schematic od Rev.B
    [Solaranlage.kicad_sch]
2024-04-17 Rev.B -> Rev.C
    [Solaranlage-B_Cu.gbr, Solaranlage-B_Mask.gbr, Solaranlage-B_Silkscreen.gbr, Solaranlage-Edge_Cuts.gbr, Solaranlage-F_Cu.gbr, Solaranlage-F_Mask.gbr, Solaranlage-F_Paste.gbr, Solaranlage-F_Silkscreen.gbr]
